inertiarobotics/Pan-Tilt-Camera-A/Camera Pan Servo Standoff.stl

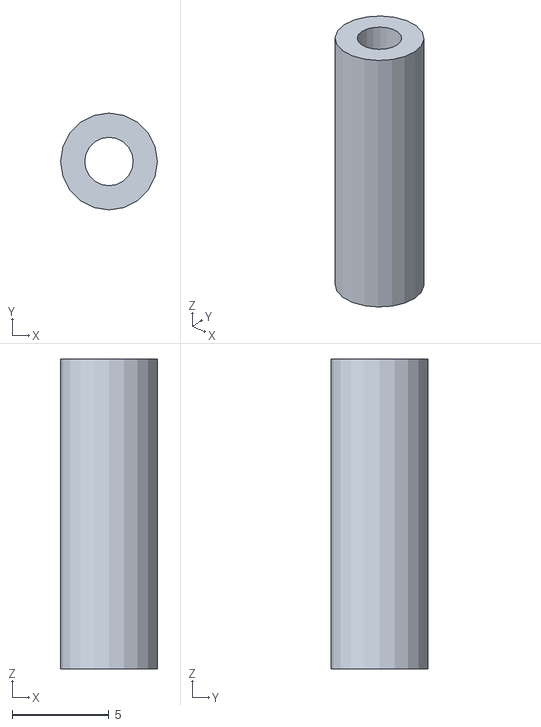
[picture p2: CAD file, 2020-12-14]
Camera Pan Servo Standoff.stl
5.00 x 5.00 x 16.0
