inertiarobotics/Pan-Tilt-Camera-A/Camera PCB Holder_v3.stl

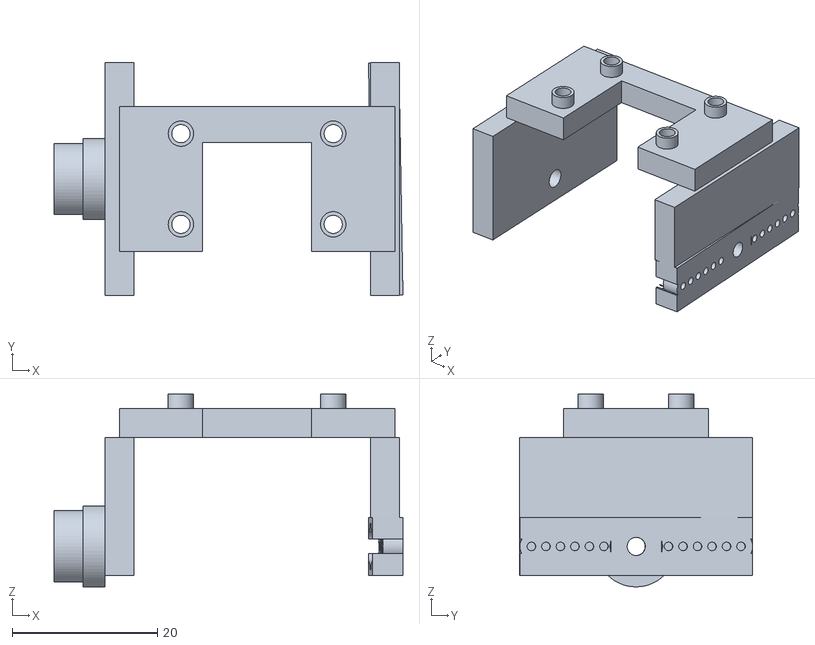
[picture p3: CAD file, 2020-12-14]
Camera PCB Holder_v3.stl
48.1 x 32.2 x 26.6
