inertiarobotics/Pan-Tilt-Camera-A/Camera Tilt Holder.stl

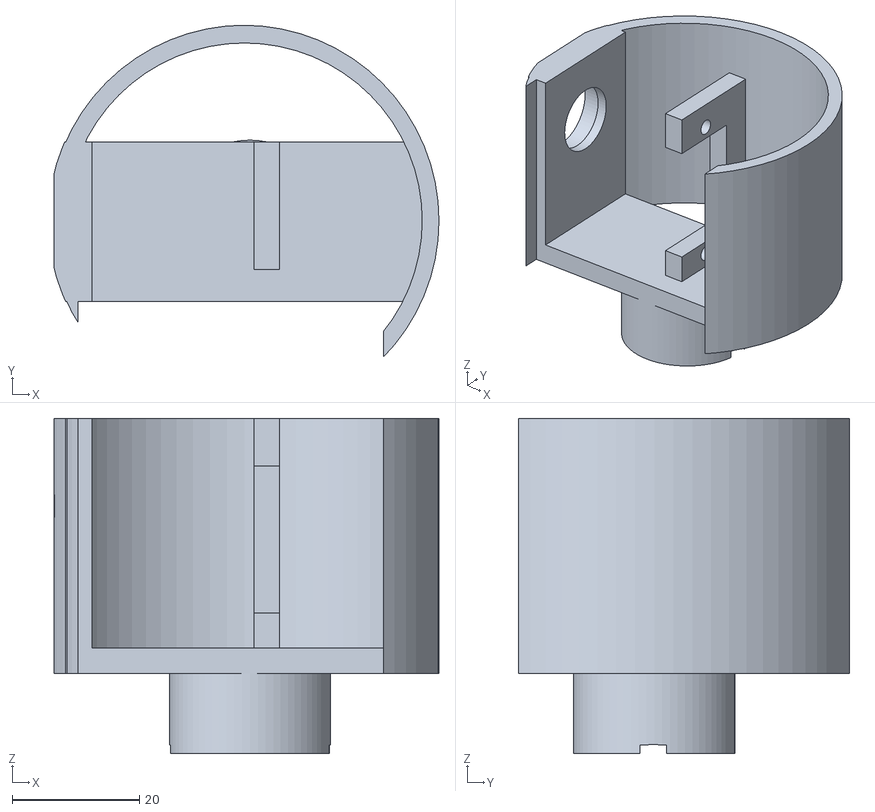
[picture p4: CAD file, 2020-12-14]
Camera Tilt Holder.stl
60.4 x 52.0 x 52.6
