inertiarobotics/Pan-Tilt-Camera-A/Camera Pan Holder.stl

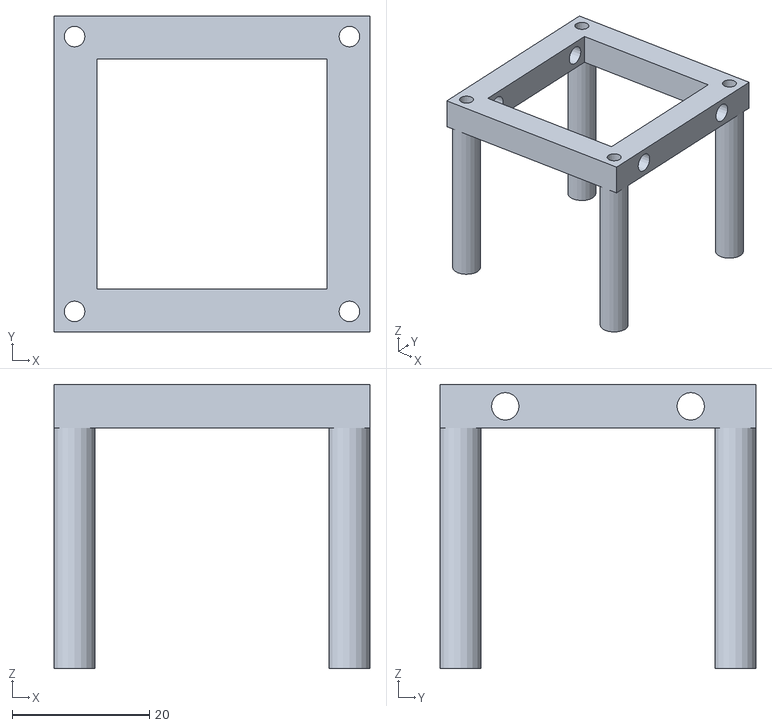
[picture p5: CAD file, 2020-12-13]
Camera Pan Holder.stl
46.0 x 46.0 x 41.3
