inertiarobotics/Pan-Tilt-Camera-A/Camera Dome Base.stl

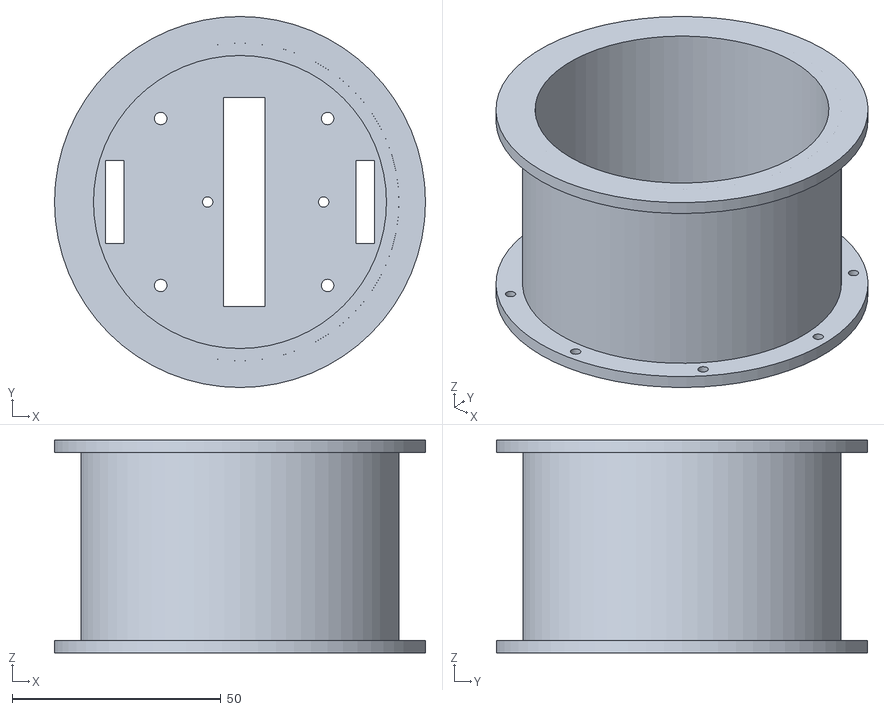
[picture p6: CAD file, 2020-12-13]
Camera Dome Base.stl
88.9 x 88.9 x 51.0
