inertiarobotics/Pan-Tilt-Camera-A/Install Instructions - Pan Tilt Camera A.pdf

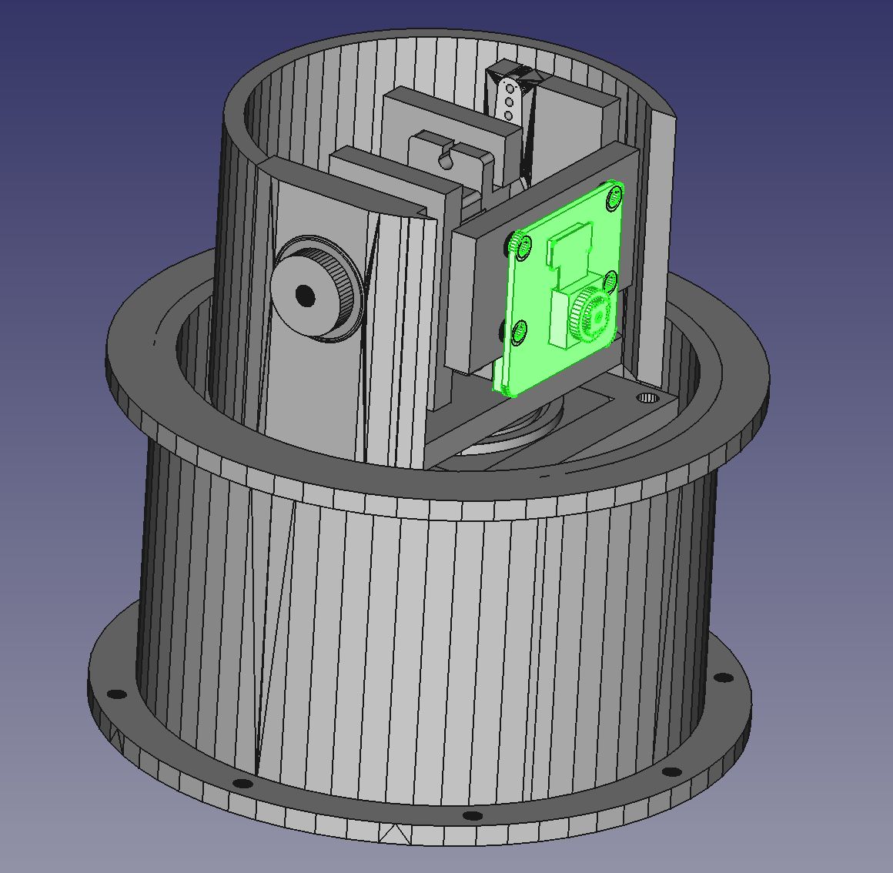
[picture p17: figure]
